hugomezok/Fuente-Buck-5V/README.md

# Fuente-Buck-5V

Proyecto para la materia "Electrónica de Potencia" de la UTN-FRBA.  
En el contexto de aplicaciones de alta frecuencia, se desarolló una fuente reductora tipo Buck con salida de 5 volts, basada en el CI LM2596.
