hugomezok/Fuente-Buck-5V/FEMM/campo-vec-1.png

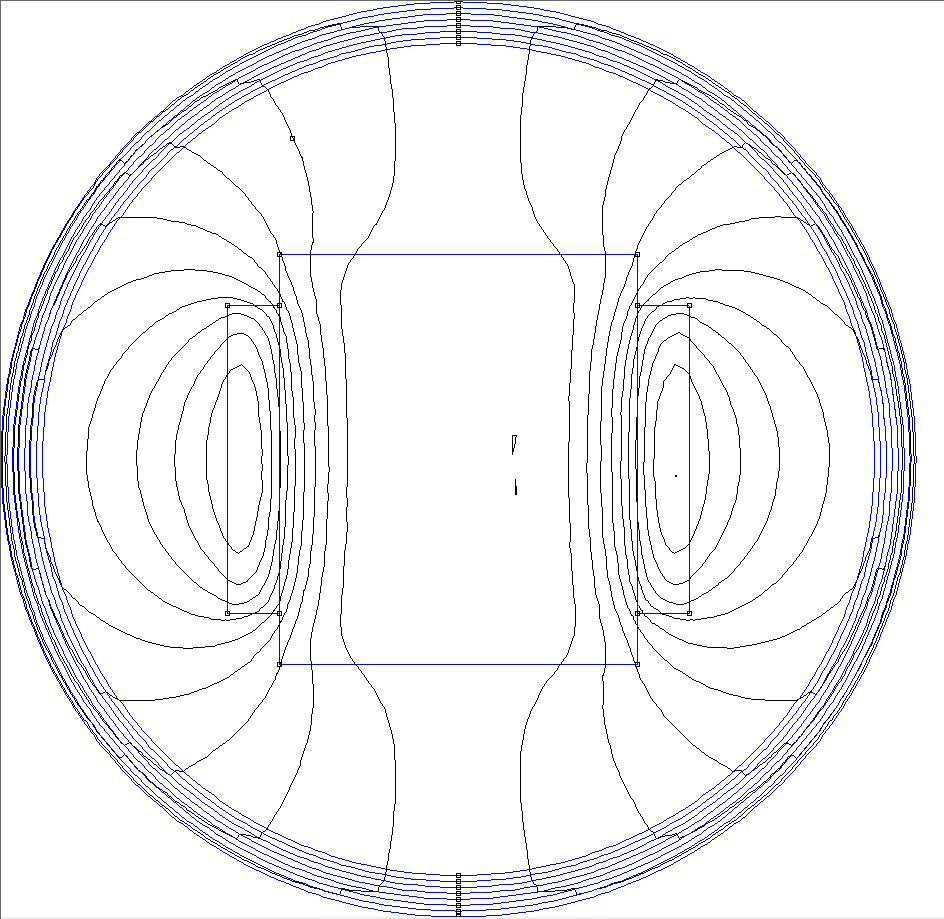
FEMM/campo-vec-1.png
