hugomezok/Fuente-Buck-5V/FEMM/campo-vec-2.png

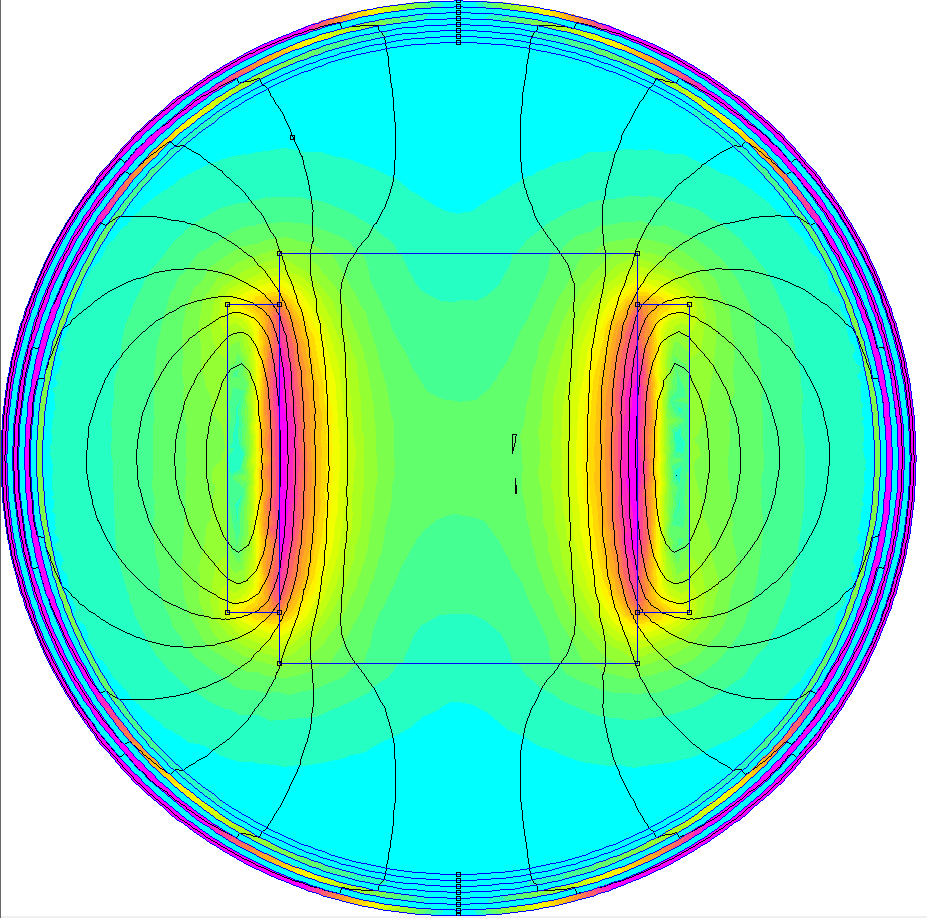
FEMM/campo-vec-2.png
