hugomezok/Fuente-Buck-5V/FEMM/campo-vec-3.png

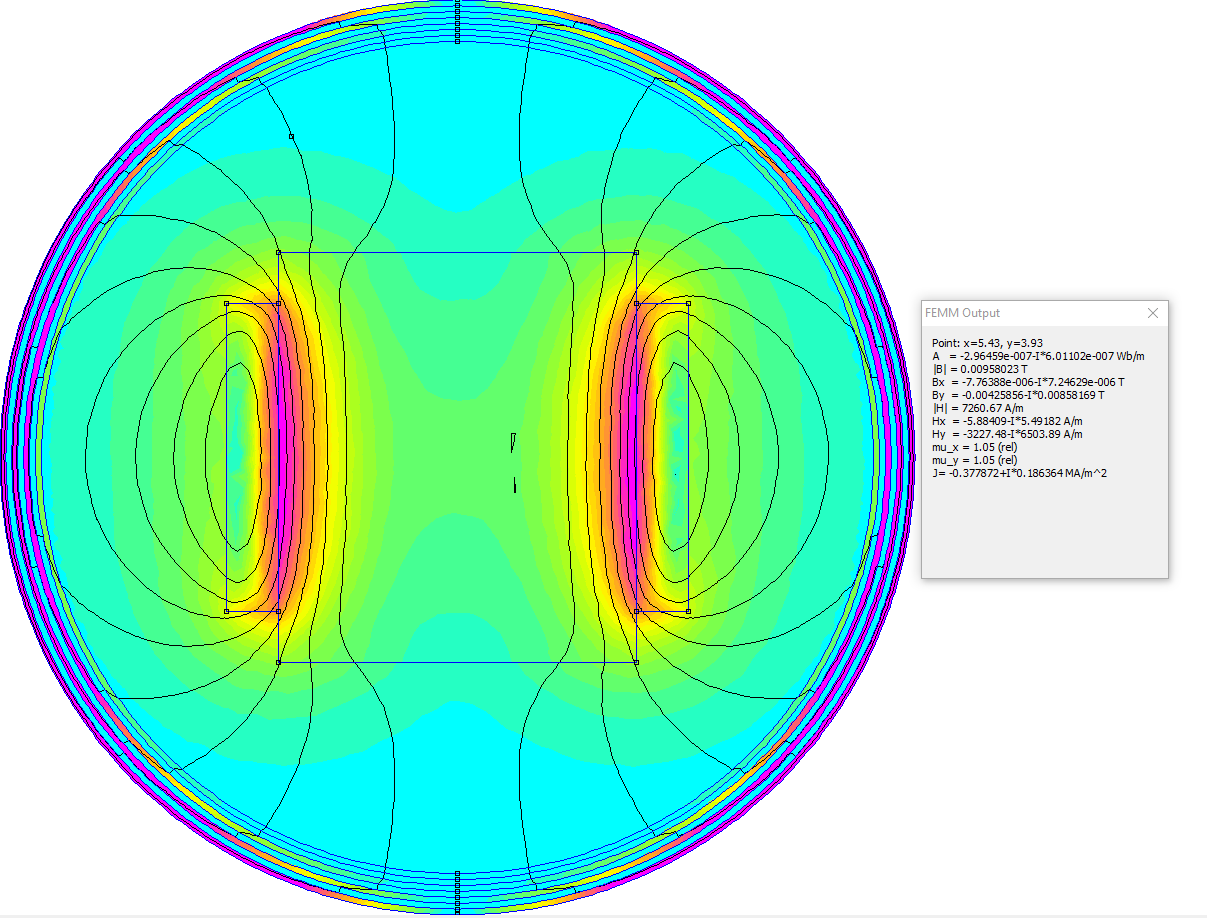
FEMM/campo-vec-3.png
