hugomezok/Fuente-Buck-5V/FEMM/campo-vec-4.png

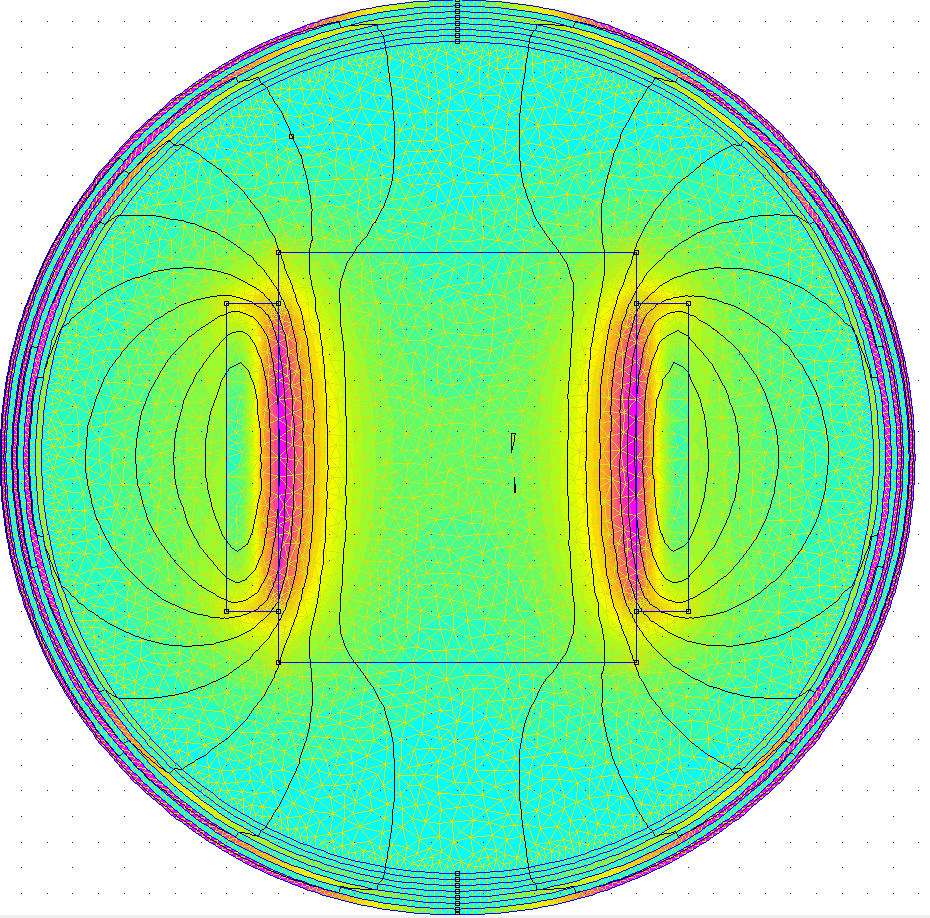
FEMM/campo-vec-4.png
