hugomezok/Fuente-Buck-5V/FEMM/tesla-1.png

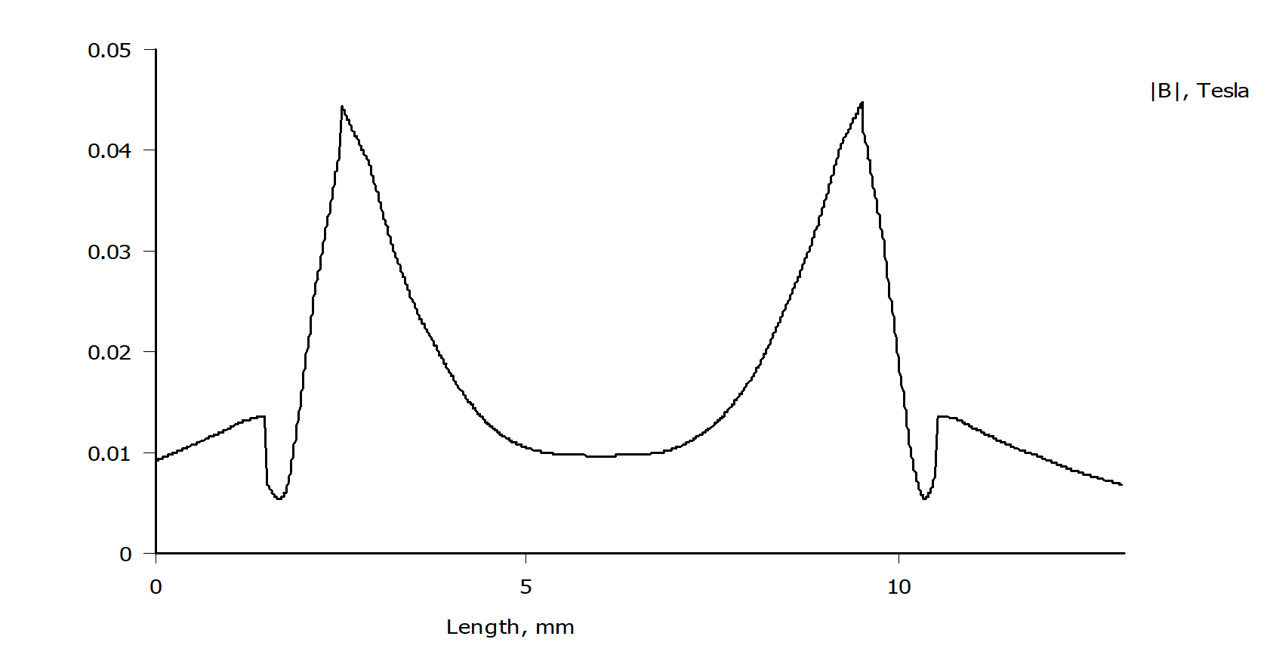
FEMM/tesla-1.png
