hugomezok/Fuente-Buck-5V/Imagenes/BoardCompleto.png

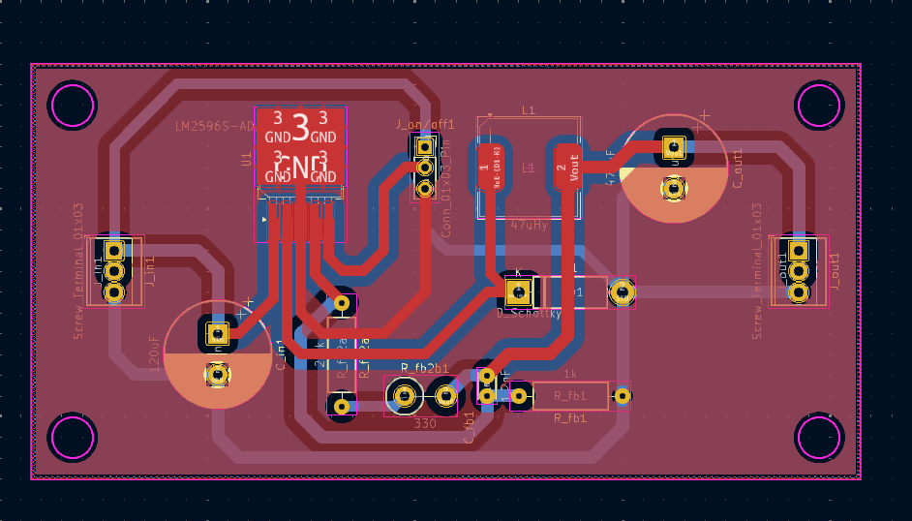
Imagenes/BoardCompleto.png
