hugomezok/Fuente-Buck-5V/Imagenes/BoardInferior.png

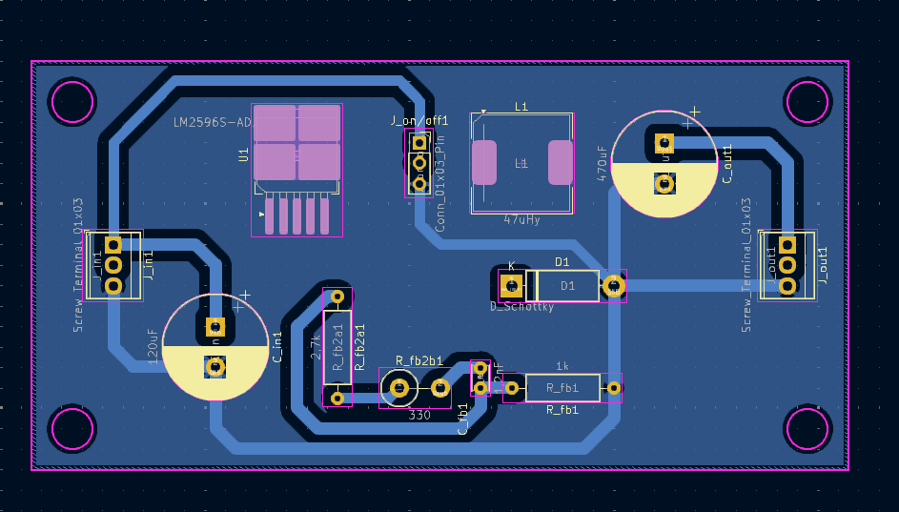
Imagenes/BoardInferior.png
