hugomezok/Fuente-Buck-5V/Imagenes/BoardSuperior.png

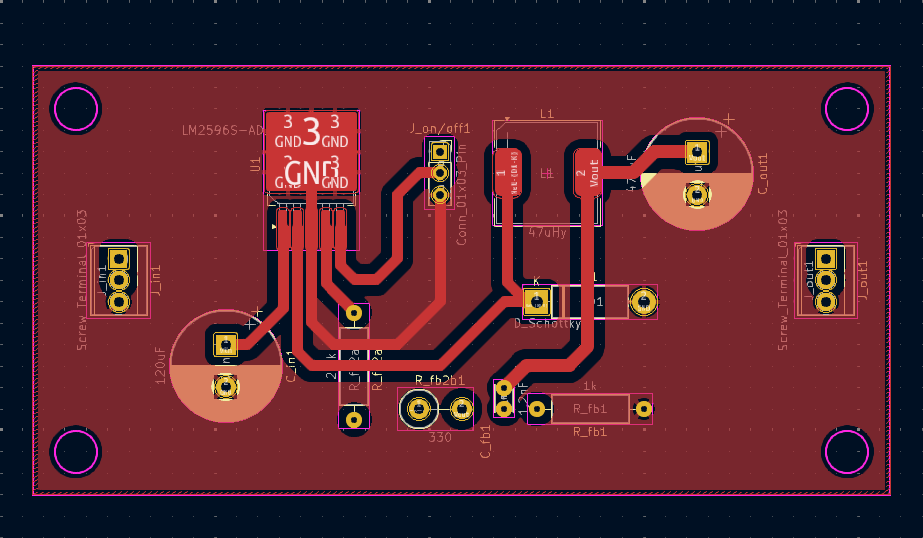
Imagenes/BoardSuperior.png
