hugomezok/Fuente-Buck-5V/Imagenes/Esquematico.png

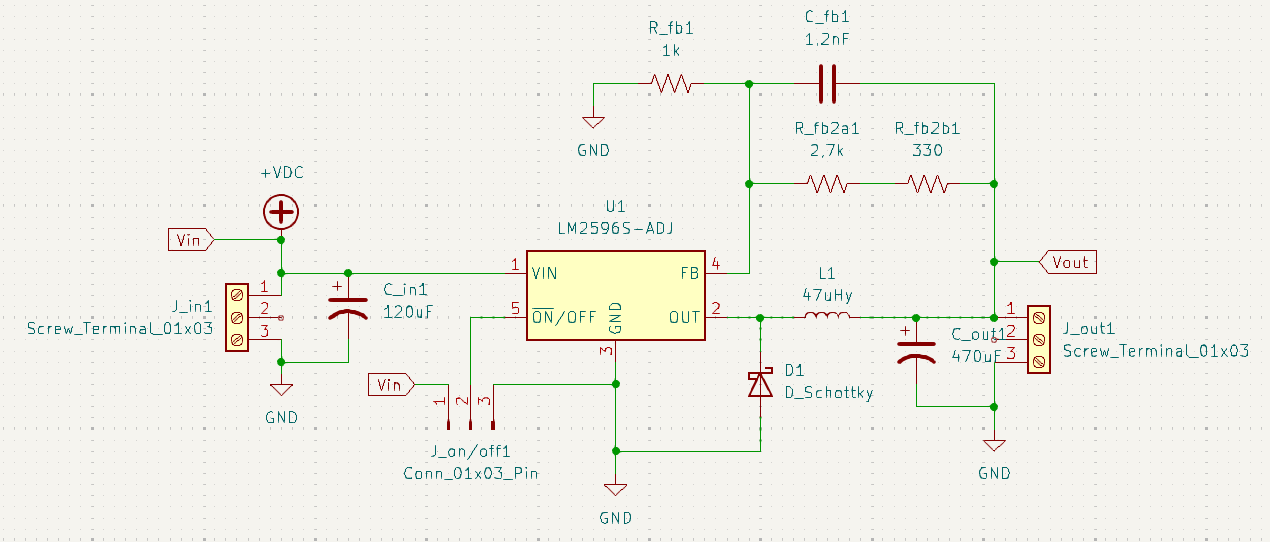
Imagenes/Esquematico.png
