hugomezok/Fuente-Buck-5V/Imagenes/ltspice-sch.png

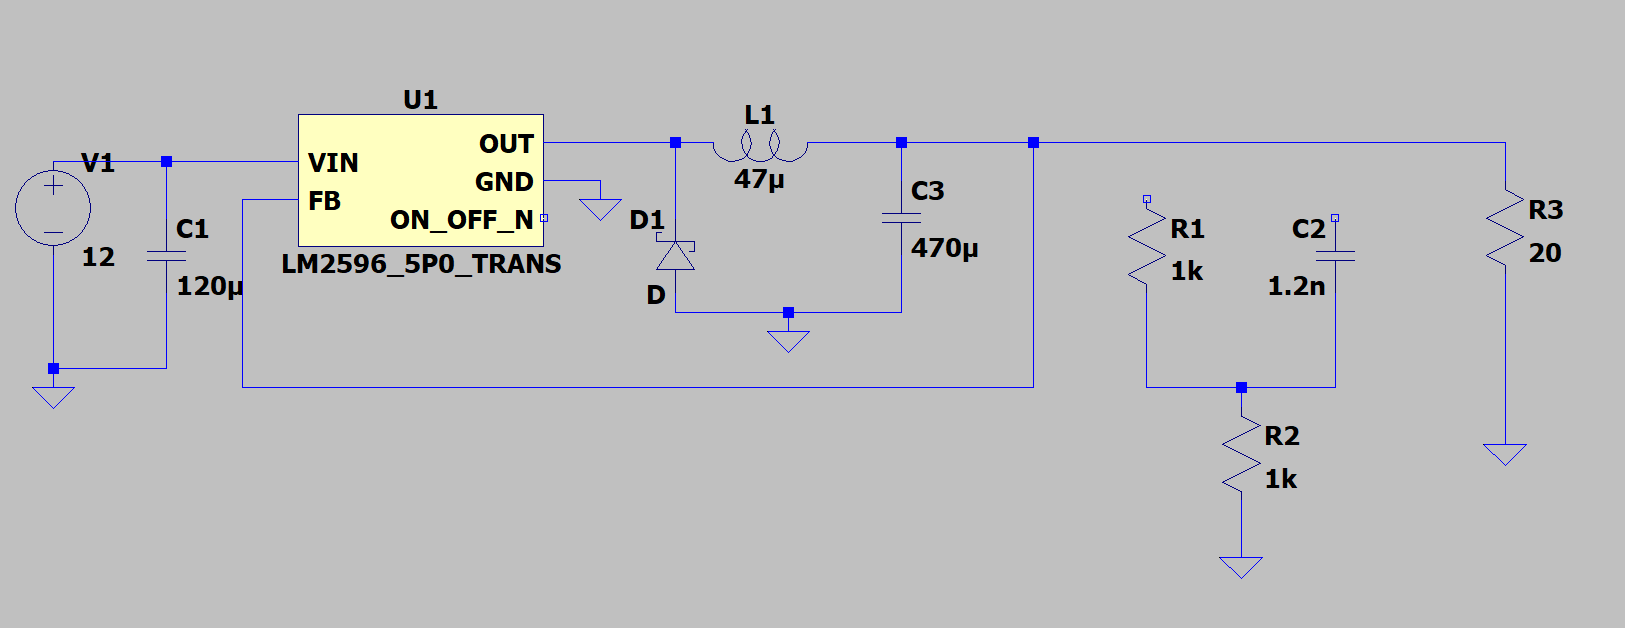
Imagenes/ltspice-sch.png
