hugomezok/Fuente-Buck-5V/Imagenes/vout.png

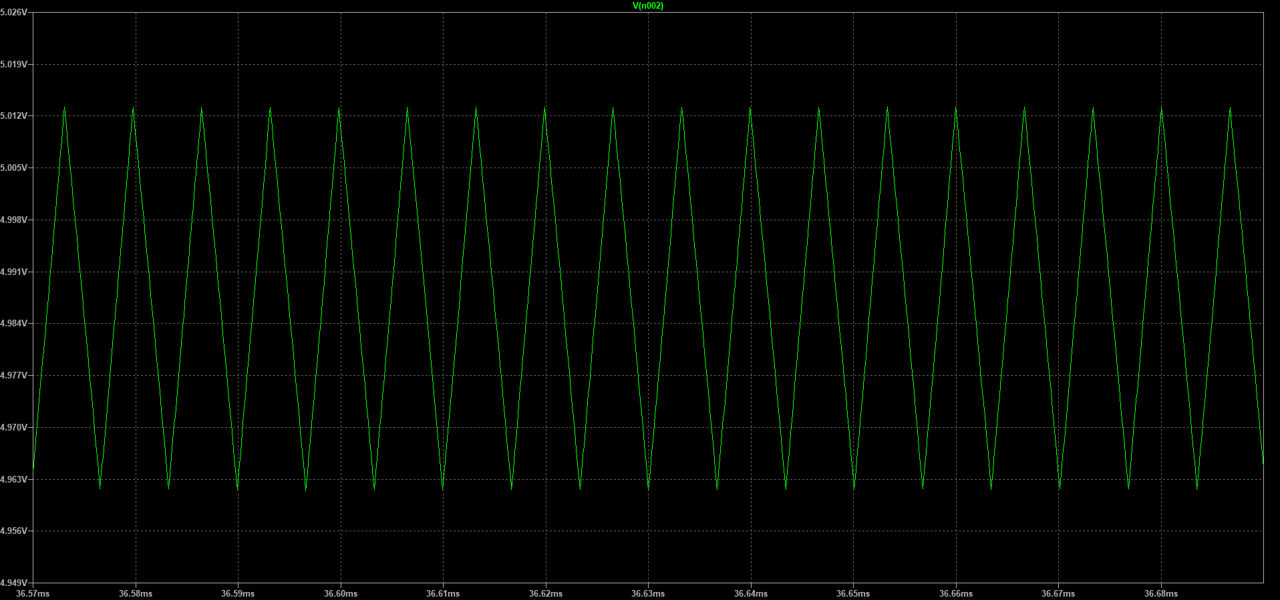
Imagenes/vout.png
