hugomezok/Fuente-Buck-5V/LTSpice/Imagenes_Simulacion/5V-3A/esquematico-33u.png

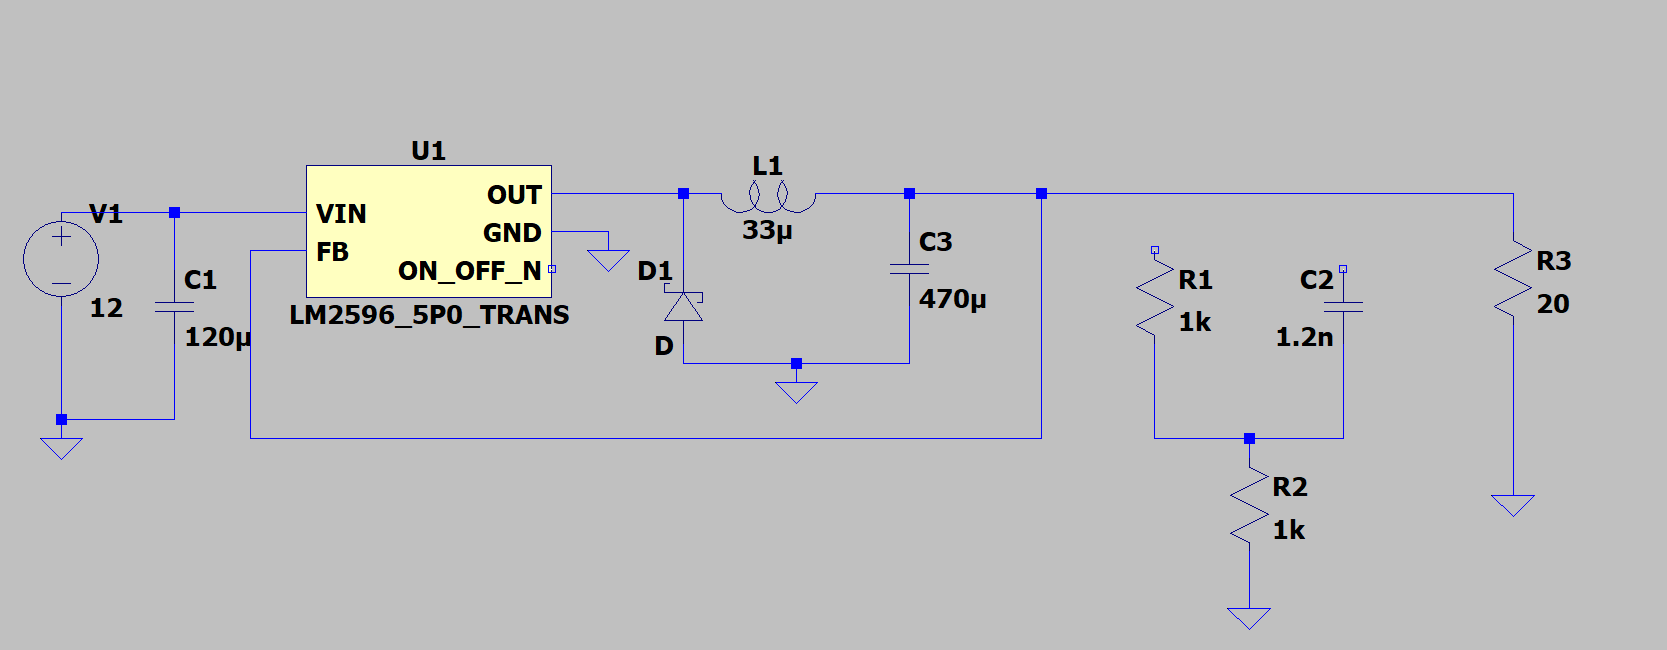
LTSpice/Imagenes_Simulacion/5V-3A/esquematico-33u.png
