hugomezok/Fuente-Buck-5V/LTSpice/Imagenes_Simulacion/5V-3A/Iin.png

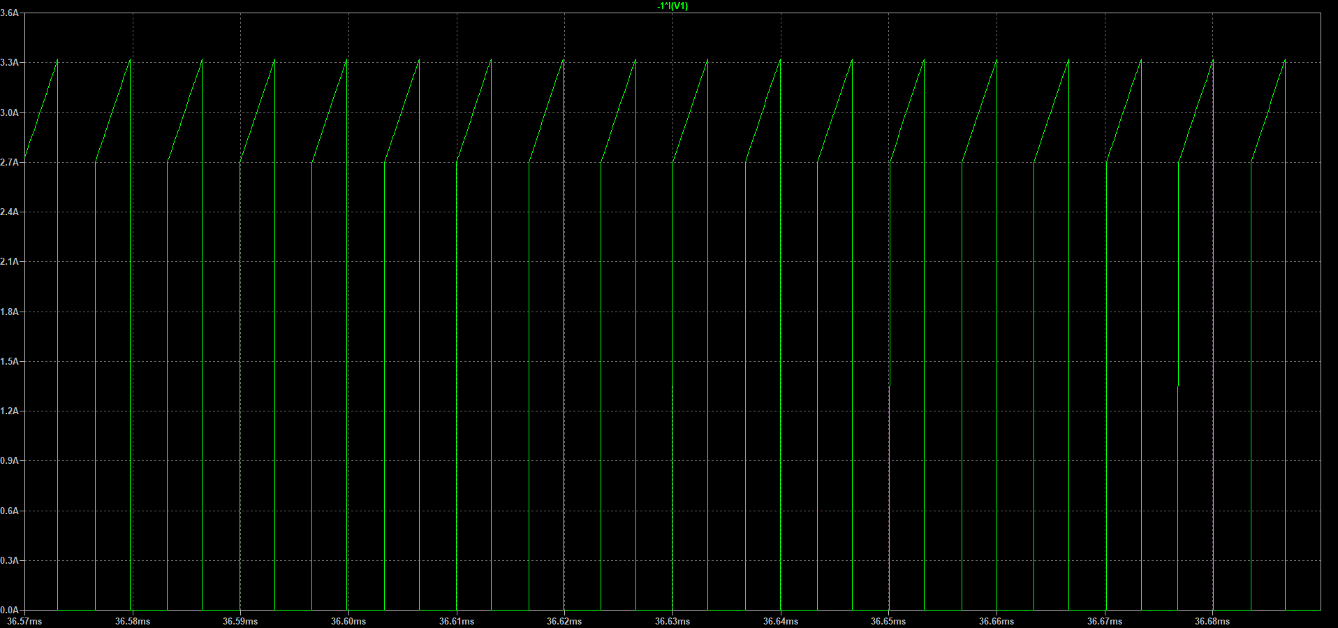
LTSpice/Imagenes_Simulacion/5V-3A/Iin.png
