hugomezok/Fuente-Buck-5V/LTSpice/Imagenes_Simulacion/5V-3A/il-con-id-con-iin.png

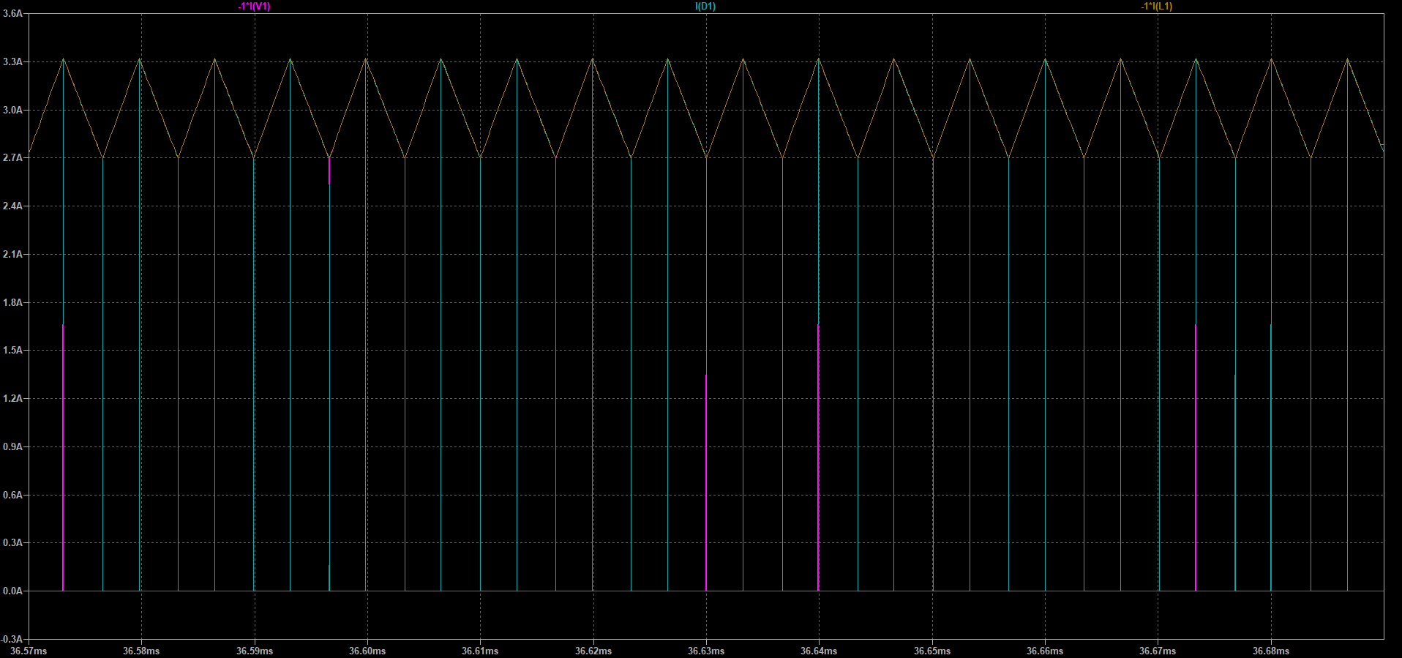
LTSpice/Imagenes_Simulacion/5V-3A/il-con-id-con-iin.png
