hugomezok/Fuente-Buck-5V/LTSpice/Imagenes_Simulacion/5V-3A/il.png

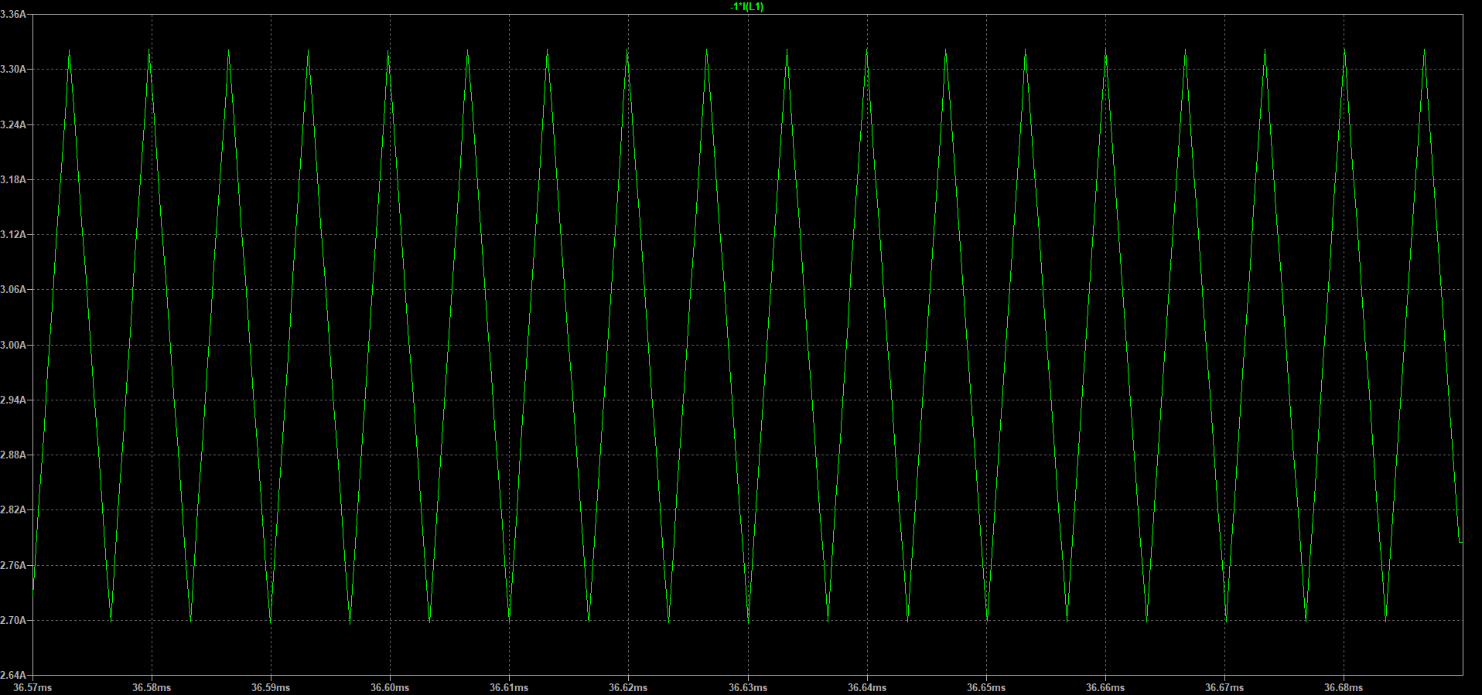
LTSpice/Imagenes_Simulacion/5V-3A/il.png
