hugomezok/Fuente-Buck-5V/LTSpice/Imagenes_Simulacion/5V-3A/iout.png

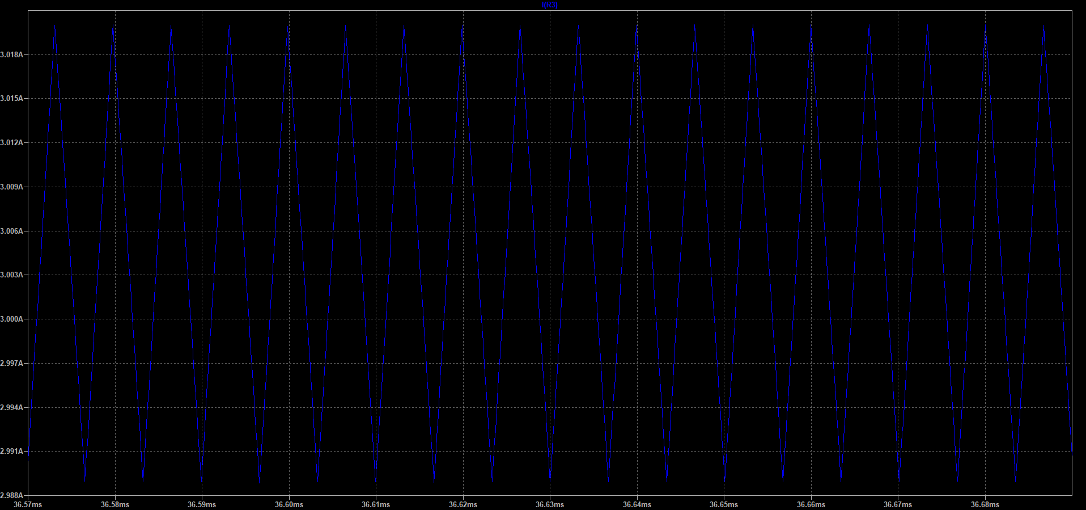
LTSpice/Imagenes_Simulacion/5V-3A/iout.png
