hugomezok/Fuente-Buck-5V/LTSpice/Imagenes_Simulacion/5V-3A/vdiodo-47u.png

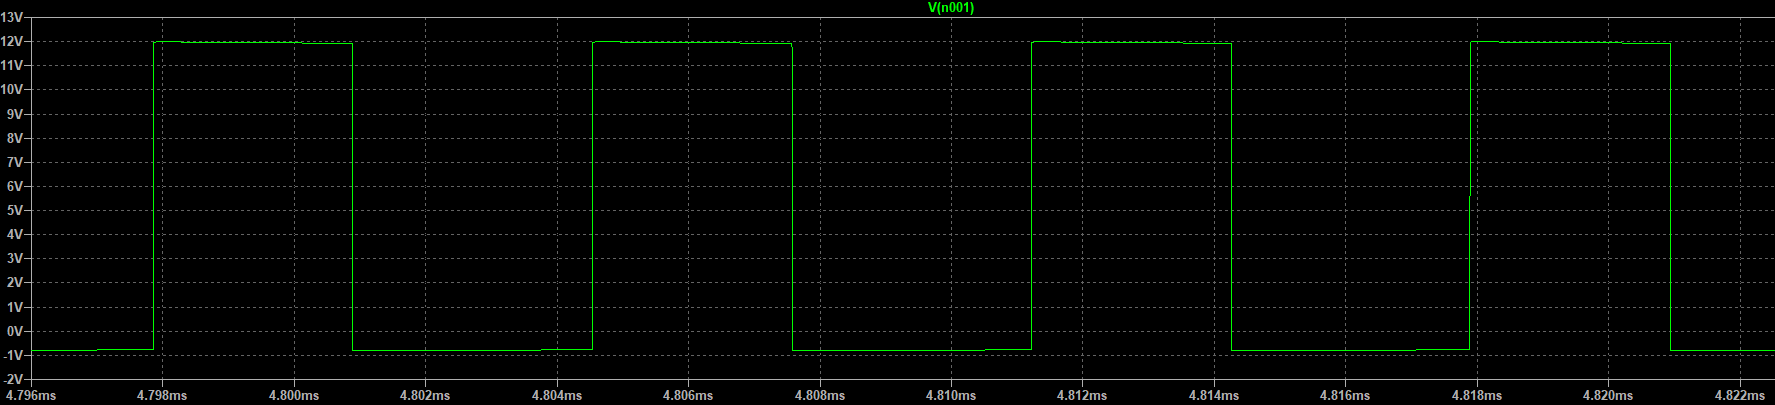
LTSpice/Imagenes_Simulacion/5V-3A/vdiodo-47u.png
