hugomezok/Fuente-Buck-5V/Imagenes/Board.pdf

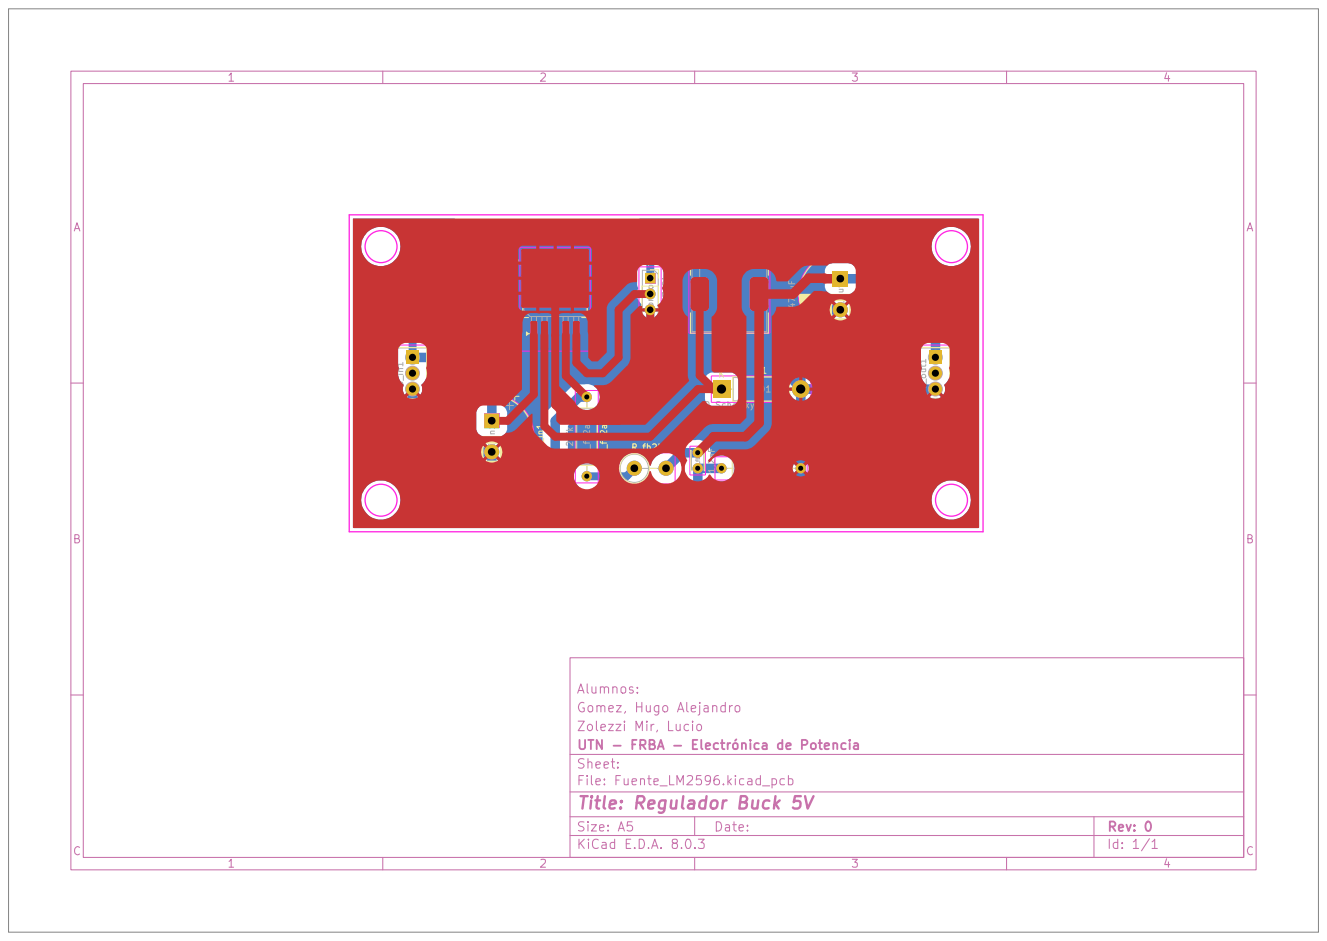
[picture p40: page 1]
