hugomezok/Fuente-Buck-5V/Imagenes/Esquematico.pdf

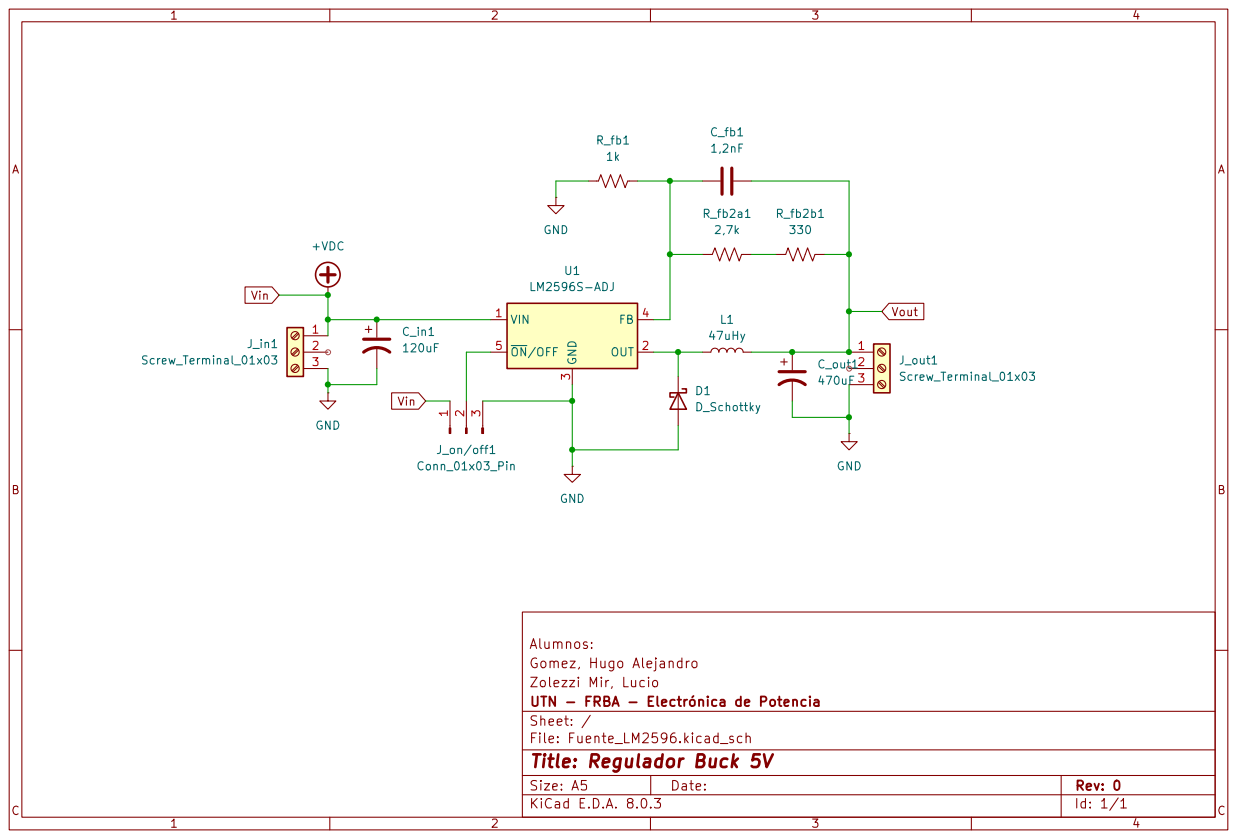
[picture p41: page 1]
