hugomezok/Fuente-Buck-5V/LTSpice/simulacion.asc

C1: cap; 120µ; Rser=25m
C2: cap; 1.2n
C3: cap; 470µ; Rser=87m
D1: schottky
L1: ind; 47µ; Rser=33m
R1: res; 1k
R2: res; 1k
R3: res; 20
U2: LM2596_5P0_TRANS
V1: voltage; 12
Named nets: 0
.tran 0 10m 0
