hugomezok/Fuente-Buck-5V/(list of files, drawings)

Other design files:
LTSpice/PROYECTO-FUENTE-SW-5V-3A.DSN
LTSpice/proyecto-fuente-sw-5v-3a.opj
