hugomezok/Fuente-Buck-5V/KiCad/Fuente_LM2596.kicad_pcb

## KiCad design KiCad/Fuente_LM2596.kicad_pcb (2025-04-02)

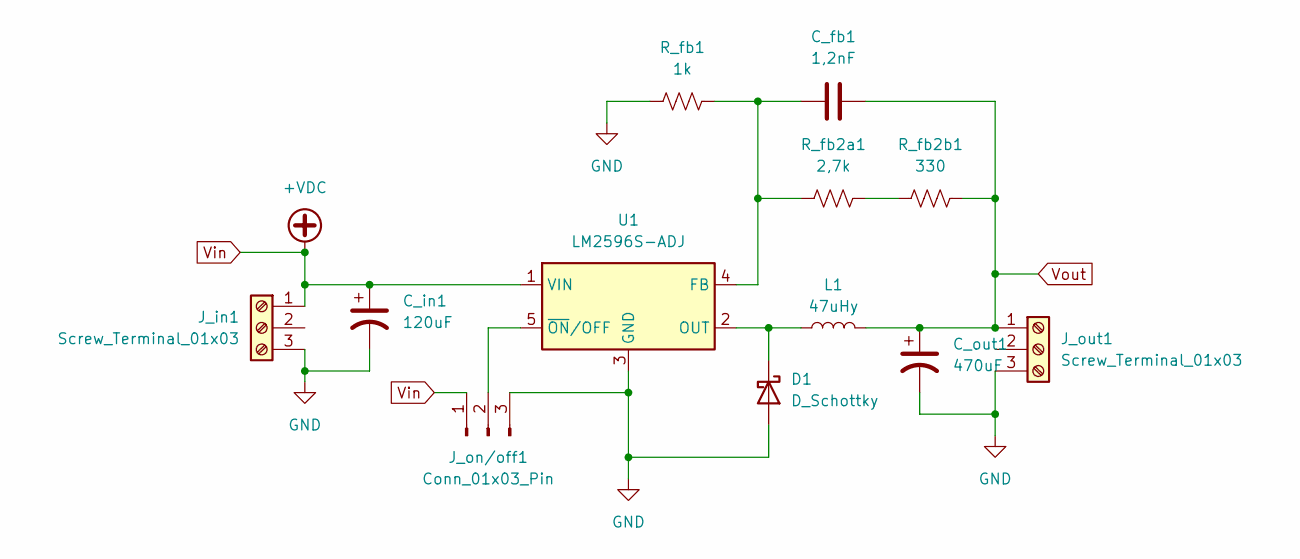
[picture p42: schematic Fuente_LM2596.kicad_sch, Regulador Buck 5V]

Parts:
C_fb1: 1,2nF; C_Disc_D3.0mm_W2.0mm_P2.50mm
C_in1: 120uF; CP_Radial_D13.0mm_P5.00mm
C_out1: 470uF; CP_Radial_D13.0mm_P5.00mm
D1: D_Schottky; D_5W_P12.70mm_Horizontal
J_in1: Screw_Terminal_01x03; TerminalBlock_TE_282834-3_1x03_P2.54mm_Horizontal
J_on/off1: Conn_01x03_Pin; PinSocket_1x03_P2.54mm_Vertical
J_out1: Screw_Terminal_01x03; TerminalBlock_TE_282834-3_1x03_P2.54mm_Horizontal
L1: 47uHy; L_Coilcraft_MSS1210-XXX
R_fb1: 1k; R_Axial_DIN0309_L9.0mm_D3.2mm_P12.70mm_Horizontal
R_fb2a1: 2,7k; R_Axial_DIN0309_L9.0mm_D3.2mm_P12.70mm_Horizontal
R_fb2b1: 330; R_Axial_DIN0414_L11.9mm_D4.5mm_P5.08mm_Vertical
U1: LM2596S-ADJ; TO-263-5_TabPin3

Connections:
GND: C_in1.2, C_out1.2, D1.2 (A), J_in1.3, J_on/off1.3, J_out1.3, R_fb1.1, U1.3 (GND)
unnamed: D1.1 (K), L1.1, U1.2 (OUT)
unnamed: J_on/off1.2, U1.5 (~ON/OFF)
unnamed: R_fb2a1.2, R_fb2b1.1
unnamed: C_fb1.1, R_fb1.2, R_fb2a1.1, U1.4 (FB)
Vin: C_in1.1, J_in1.1, J_on/off1.1, U1.1 (VIN)
Vout: C_fb1.2, C_out1.1, J_out1.1, L1.2, R_fb2b1.2

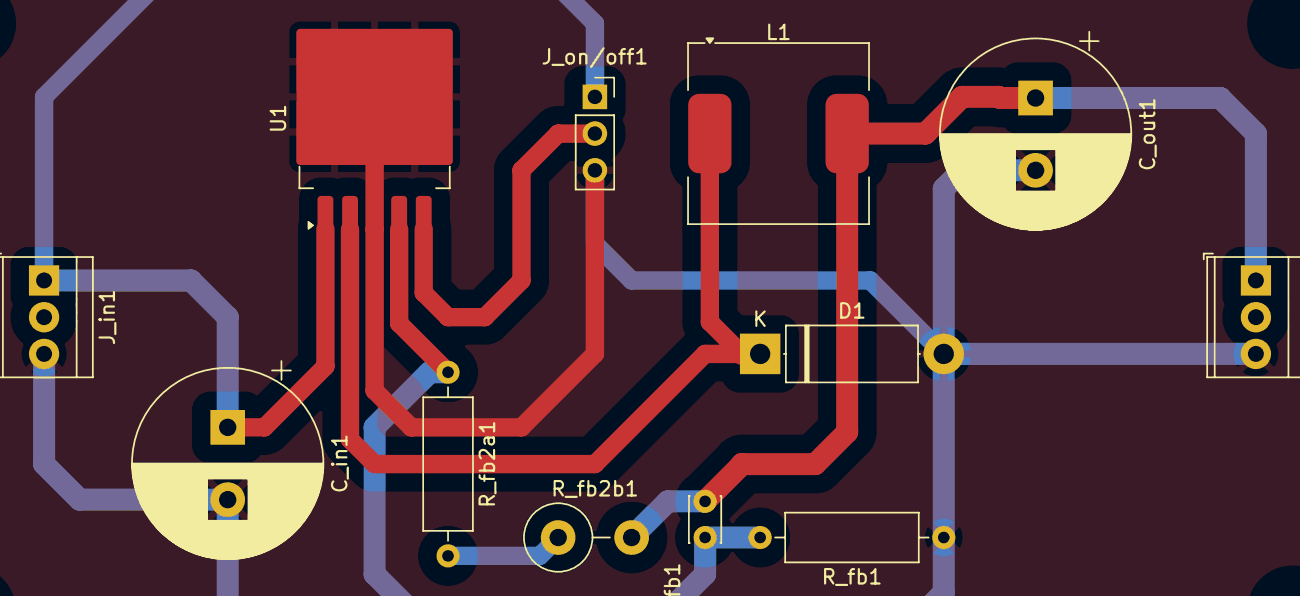
[picture p43: board Fuente_LM2596.kicad_pcb from above]

Board: 2 copper layers, 12 parts (0 on the bottom side), 7 nets.
